jhalmen/openloop-hrdwr/looper.kicad_pcb

## KiCad design looper.kicad_pcb (2020-03-23)

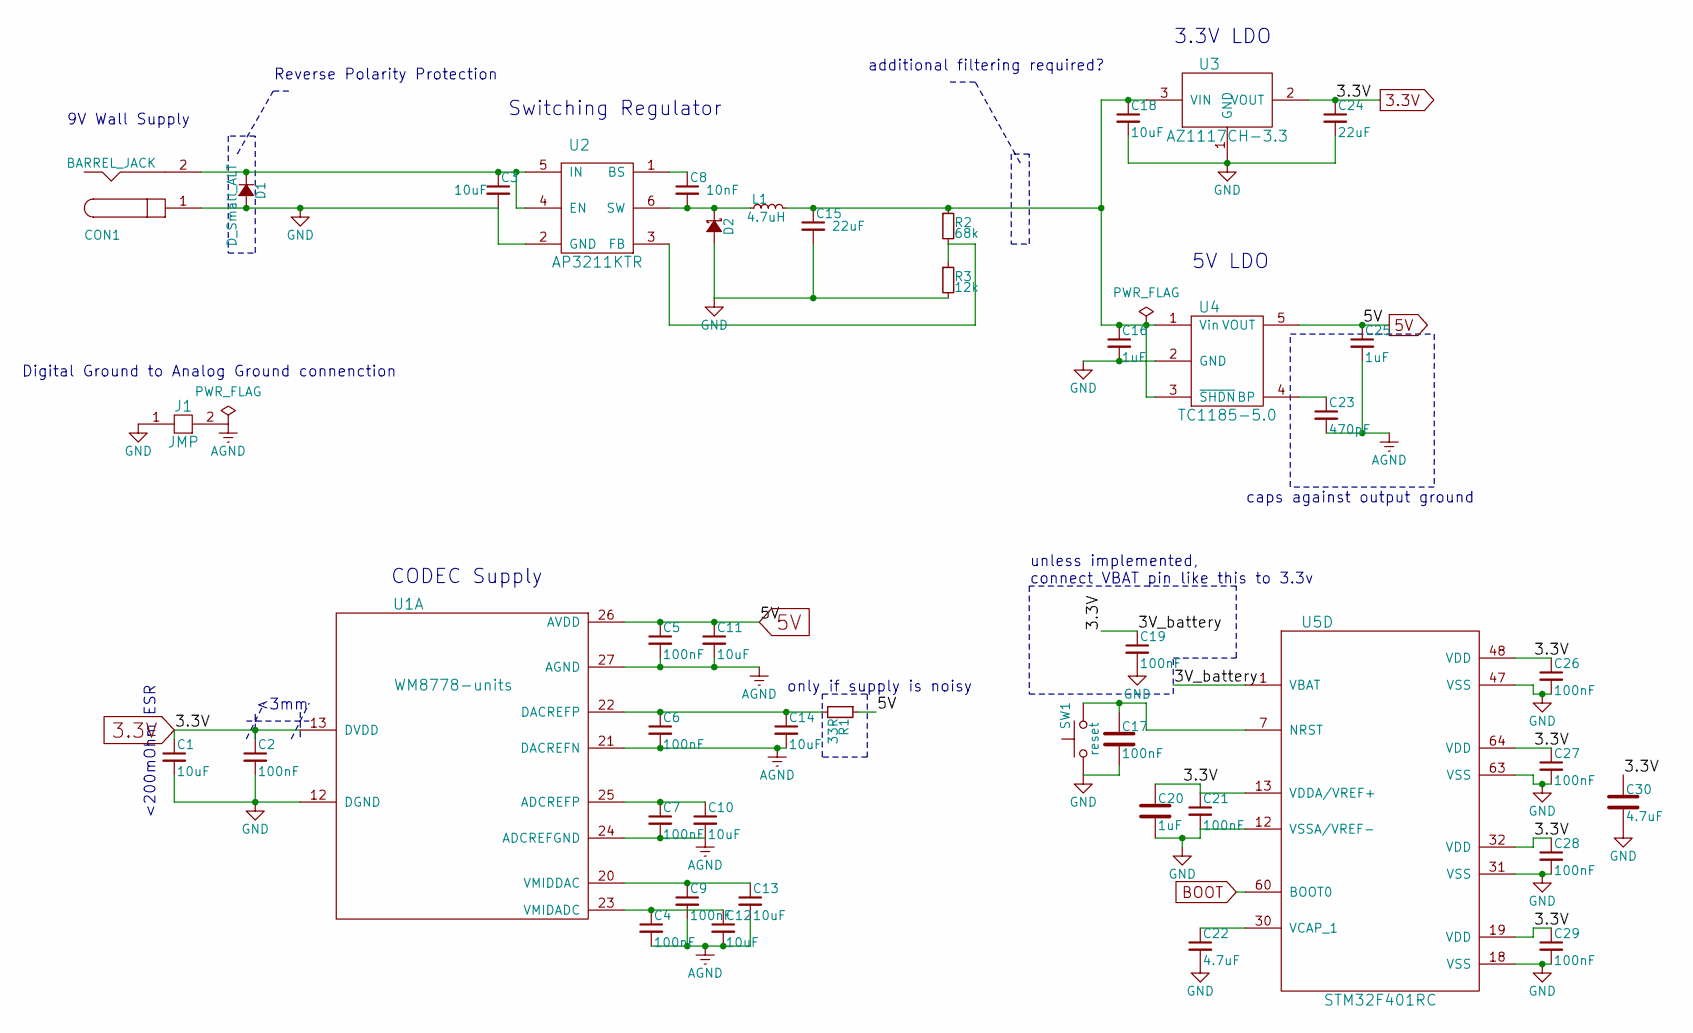
[picture p1: schematic power.sch, OpenLoop]

Parts:
C1, C3, C10, C11, C12, C13, C14, C18: 10uF; C_0805_HandSoldering
C2, C4, C5, C6, C7, C9, C17, C19, C21, C26, C27, C28, C29: 100nF; C_0805_HandSoldering
C8: 10nF; C_0805_HandSoldering
C15, C24: 22uF; C_0805_HandSoldering
C16, C20, C25: 1uF; C_0805_HandSoldering
C22, C30: 4.7uF; C_0805_HandSoldering
C23: 470pF; C_0805_HandSoldering
CON1: BARREL_JACK; PJ-037A
D1: D_Small_ALT; D_DO-35_SOD27_P7.62mm_Horizontal
D2: D_Schottky_Small_ALT; D_DO-35_SOD27_P7.62mm_Horizontal
J1: JMP; netconnector
L1: 4.7uH; Resistor_SMDuniversal_0805to1206_HandSoldering
R1: 33R; R_Axial_DIN0207_L6.3mm_D2.5mm_P7.62mm_Horizontal
R2: 68k; R_Axial_DIN0207_L6.3mm_D2.5mm_P7.62mm_Horizontal
R3: 12k; R_Axial_DIN0207_L6.3mm_D2.5mm_P7.62mm_Horizontal
SW1: reset; SW_PUSH_6mm
U1: WM8778-units; SSOP-28_5.3x10.2mm_Pitch0.65mm_HandSolder
U2: AP3211KTR; SOT-23-6_Handsoldering
U3: AZ1117CH-3.3; SOT-223-3Lead_TabPin2_HandSoldering
U4: TC1185-5.0; SOT-23-5_HandSoldering
U5: STM32F401RC; LQFP-64_10x10mm_Pitch0.5mm_HandSolder

Connections:
3.3V: C1.1, C2.1, C19.1, C20.1, C21.1, C24.1, C26.1, C27.1, C28.1, C29.1, C30.1, U1.13 (DVDD), U3.2 (VOUT), U5.1 (VBAT), U5.13 (VDDA/VREF+), U5.19 (VDD), U5.32 (VDD), U5.48 (VDD), U5.64 (VDD); also elsewhere on the board
5V: C5.1, C11.1, C25.1, R1.1, U1.26 (AVDD), U4.5 (VOUT); also elsewhere on the board
BOOT: U5.60 (BOOT0); also elsewhere on the board
GND: C1.2, C2.2, C3.2, C15.2, C16.2, C17.2, C18.2, C19.2, C20.2, C21.2, C22.2, C24.2, C26.2, C27.2, C28.2, C29.2, C30.2, CON1.1, D1.2 (A), D2.2 (A), J1.1, R3.2, SW1.1, U1.12 (DGND), U2.2 (GND), U3.1 (GND), U4.2 (GND), U5.12 (VSSA/VREF-), U5.18 (VSS), U5.31 (VSS), U5.47 (VSS), U5.63 (VSS); also elsewhere on the board
unnamed: C3.1, CON1.2, D1.1 (K), U2.4 (EN), U2.5 (IN)
unnamed: C8.1, U2.1 (BS)
unnamed: C8.2, D2.1 (K), L1.1, U2.6 (SW)
unnamed: C7.1, C10.1, U1.25 (ADCREFP)
unnamed: C4.1, C12.1, U1.23 (VMIDADC)
unnamed: C9.1, C13.1, U1.20 (VMIDDAC)
unnamed: C6.1, C14.1, R1.2, U1.22 (DACREFP)
unnamed: C15.1, C16.1, C18.1, L1.2, R2.1, U3.3 (VIN), U4.1 (Vin), U4.3 (~SHDN)
unnamed: C17.1, SW1.2, U5.7 (NRST)
unnamed: C22.1, U5.30 (VCAP_1)
unnamed: C23.1, U4.4 (BP)
unnamed: R2.2, R3.1, U2.3 (FB)

Notes on the sheet:
Digital Ground to Analog Ground connenction
9V Wall Supply
Reverse Polarity Protection
additional filtering required?
<3mm
<200mOhm ESR
only if supply is noisy
CODEC Supply
Switching Regulator
3.3V LDO
5V LDO
caps against output ground
unless implemented, connect VBAT pin like this to 3.3v

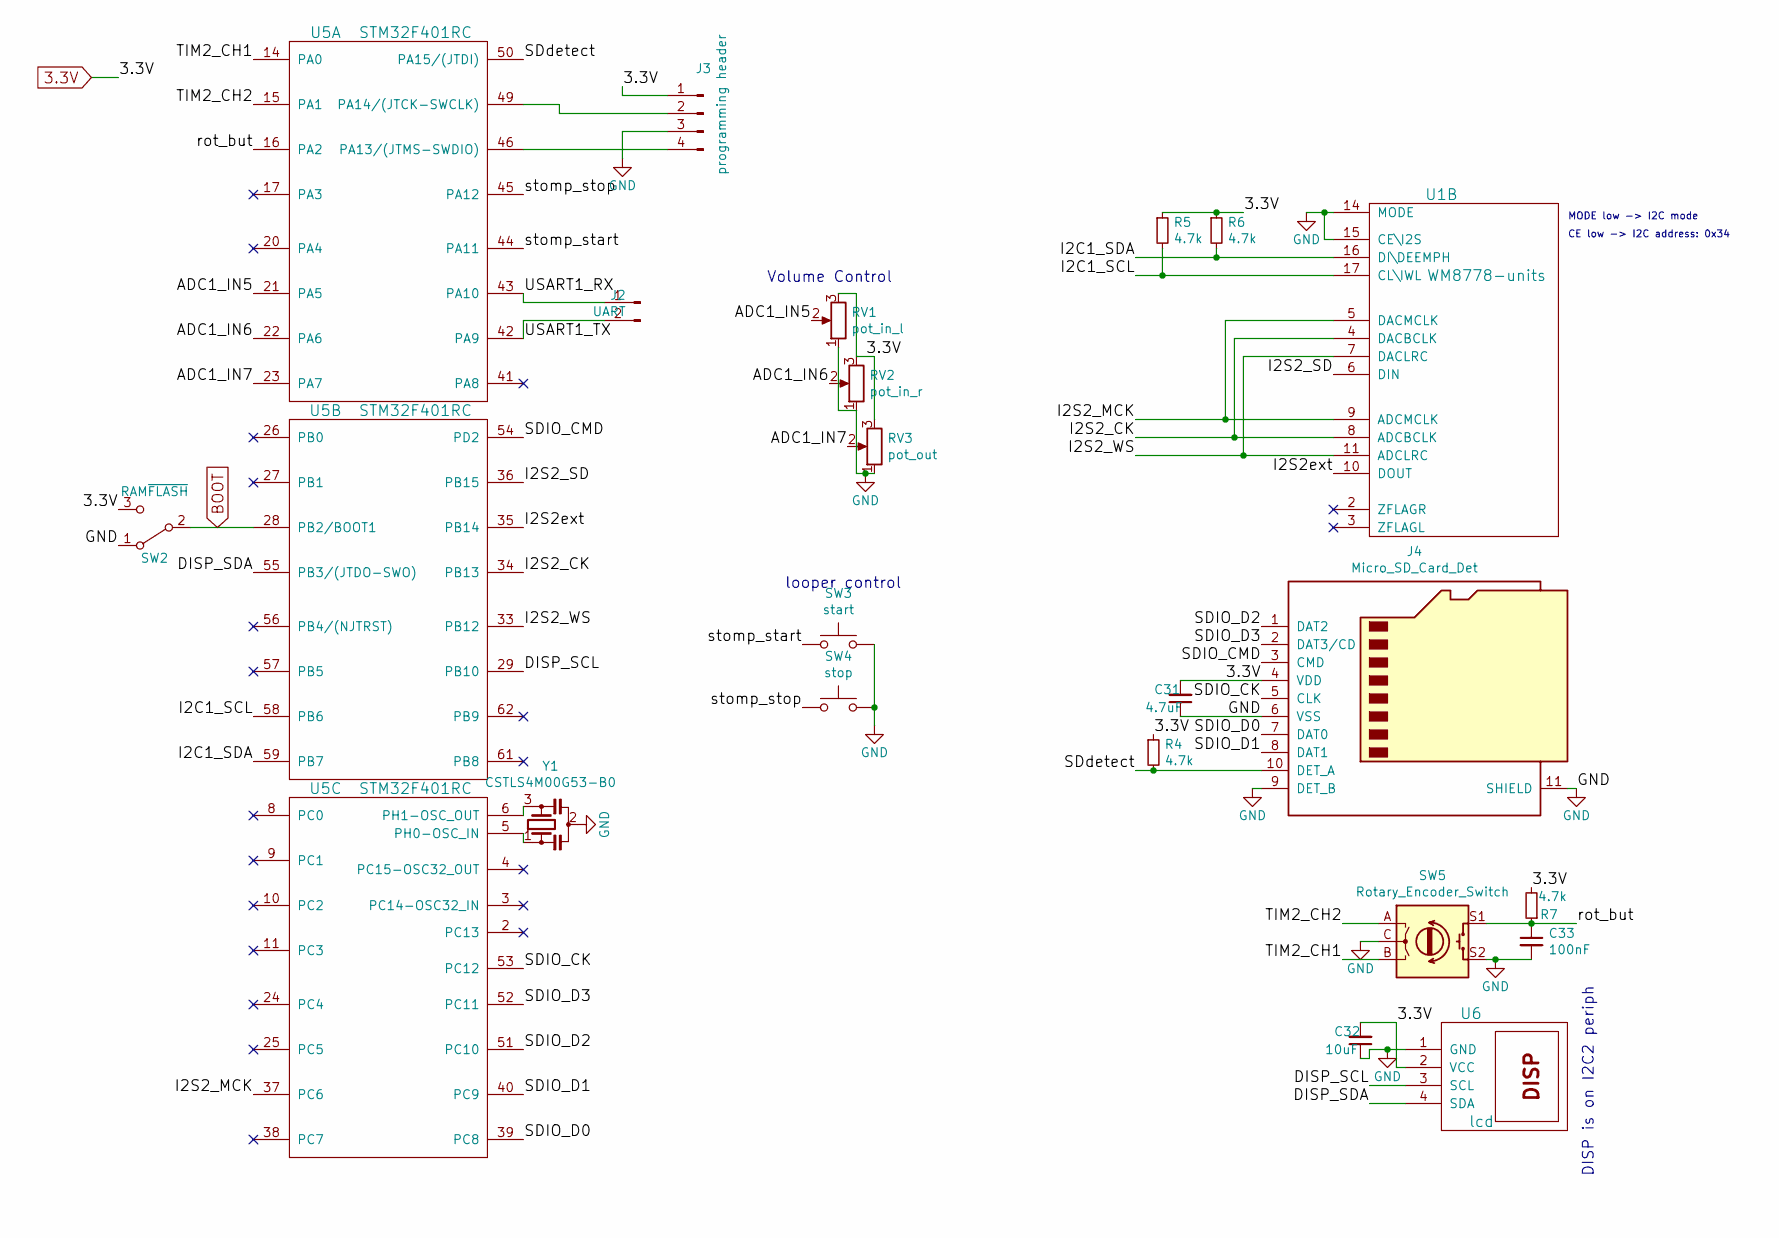
[picture p2: schematic controller.sch, OpenLoop]

Parts:
C31: 4.7uF; C_0805_HandSoldering
C32: 10uF; C_0805_HandSoldering
C33: 100nF; C_0805_HandSoldering
J2: UART; Pin_Header_Straight_1x02_Pitch2.54mm
J3: programming header; Pin_Header_Straight_1x04_Pitch2.54mm
J4: Micro_SD_Card_Det; SD-503182_Molex_micro_SD_HandSolder
R4, R5, R6, R7: 4.7k; R_Axial_DIN0207_L6.3mm_D2.5mm_P7.62mm_Horizontal
RV1: pot_in_l; Potentiometer_WirePads_Small
RV2: pot_in_r; Potentiometer_WirePads_Small
RV3: pot_out; Potentiometer_WirePads_Small
SW2: RAM~FLASH; SW_Micro_SPST
SW3: start; SW_PUSH_6mm
SW4: stop; SW_PUSH_6mm
SW5: Rotary_Encoder_Switch; EN11-HSM
U1: WM8778-units; SSOP-28_5.3x10.2mm_Pitch0.65mm_HandSolder
U5: STM32F401RC; LQFP-64_10x10mm_Pitch0.5mm_HandSolder
U6: lcd; Socket_Strip_Straight_1x04_Pitch2.54mm
Y1: CSTLS4M00G53-B0; Resonator_muRata_CSTLSxxxG-3pin_w8.0mm_h3.0mm

Connections:
3.3V: C31.2, C32.2, J3.1, J4.4 (VDD), R4.1, R5.1, R6.1, R7.2, RV1.3, RV2.3, RV3.3, SW2.3 (C), U6.2 (VCC); also elsewhere on the board
/controller/ADC1_IN5: RV1.2, U5.21 (PA5)
/controller/ADC1_IN6: RV2.2, U5.22 (PA6)
/controller/ADC1_IN7: RV3.2, U5.23 (PA7)
/controller/DISP_SCL: U5.29 (PB10), U6.3 (SCL)
/controller/DISP_SDA: U5.55 (PB3/(JTDO-SWO)), U6.4 (SDA)
/controller/I2C1_SCL: R5.2, U1.17 (CL\IWL), U5.58 (PB6)
/controller/I2C1_SDA: R6.2, U1.16 (DI\DEEMPH), U5.59 (PB7)
/controller/I2S2_CK: U1.4 (DACBCLK), U1.8 (ADCBCLK), U5.34 (PB13)
/controller/I2S2_MCK: U1.5 (DACMCLK), U1.9 (ADCMCLK), U5.37 (PC6)
/controller/I2S2_SD: U1.6 (DIN), U5.36 (PB15)
/controller/I2S2_WS: U1.7 (DACLRC), U1.11 (ADCLRC), U5.33 (PB12)
/controller/I2S2ext: U1.10 (DOUT), U5.35 (PB14)
/controller/SDIO_CK: J4.5 (CLK), U5.53 (PC12)
/controller/SDIO_CMD: J4.3 (CMD), U5.54 (PD2)
/controller/SDIO_D0: J4.7 (DAT0), U5.39 (PC8)
/controller/SDIO_D1: J4.8 (DAT1), U5.40 (PC9)
/controller/SDIO_D2: J4.1 (DAT2), U5.51 (PC10)
/controller/SDIO_D3: J4.2 (DAT3/CD), U5.52 (PC11)
/controller/SDdetect: J4.10 (DET_A), R4.2, U5.50 (PA15/(JTDI))
/controller/TIM2_CH1: SW5.B, U5.14 (PA0)
/controller/TIM2_CH2: SW5.A, U5.15 (PA1)
/controller/USART1_RX: J2.1, U5.43 (PA10)
/controller/USART1_TX: J2.2, U5.42 (PA9)
/controller/rot_but: C33.1, R7.1, SW5.S1, U5.16 (PA2)
/controller/stomp_start: SW3.1, U5.44 (PA11)
/controller/stomp_stop: SW4.1, U5.45 (PA12)
BOOT: SW2.2 (B), U5.28 (PB2/BOOT1); also elsewhere on the board
GND: C31.1, C32.1, C33.2, J3.3, J4.6 (VSS), J4.9 (DET_B), J4.11 (SHIELD), RV1.1, RV2.1, RV3.1, SW2.1 (A), SW3.2, SW4.2, SW5.C, SW5.S2, U1.14 (MODE), U1.15 (CE\I2S), U6.1 (GND), Y1.2; also elsewhere on the board
unnamed: J3.2, U5.49 (PA14/(JTCK-SWCLK))
unnamed: J3.4, U5.46 (PA13/(JTMS-SWDIO))
unnamed: U5.5 (PH0-OSC_IN), Y1.1
unnamed: U5.6 (PH1-OSC_OUT), Y1.3

Notes on the sheet:
MODE low -> I2C mode
CE low -> I2C address: 0x34
DISP is on I2C2 periph
Volume Control
looper control

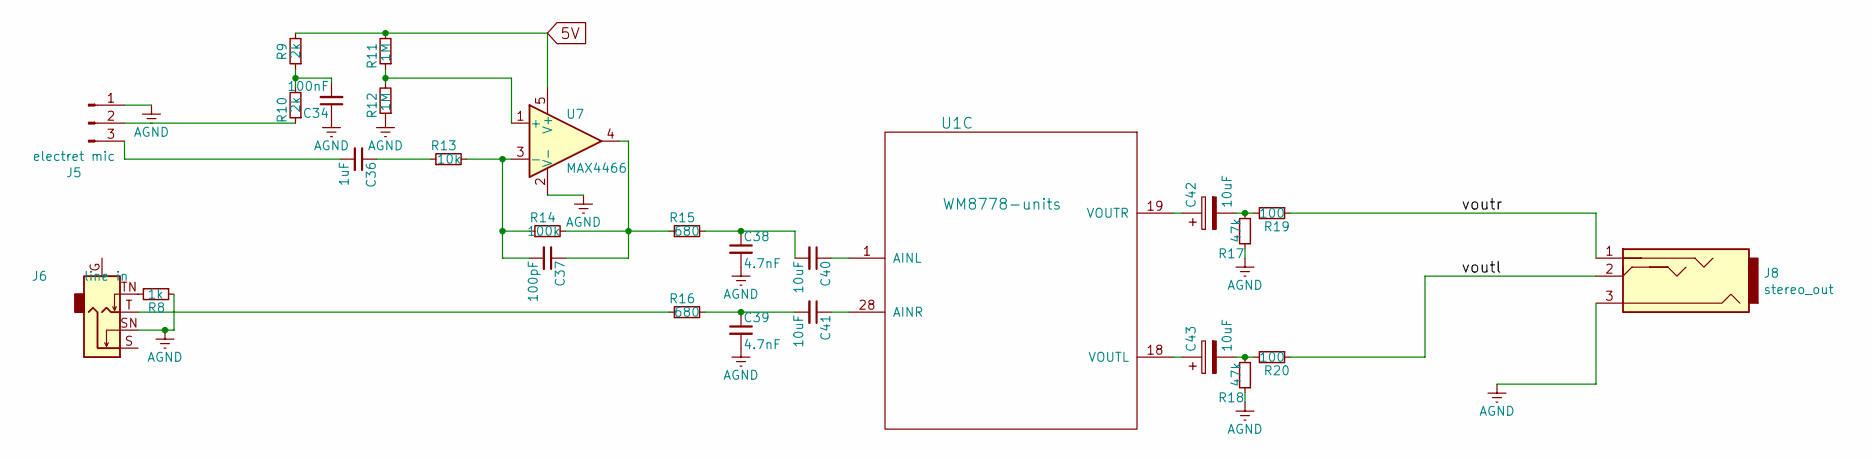
[picture p3: schematic codec.sch, OpenLoop]

Parts:
C34: 100nF; C_0805_HandSoldering
C36: 1uF; C_0805_HandSoldering
C37: 100pF; C_0805_HandSoldering
C38, C39: 4.7nF; C_0805_HandSoldering
C40, C41: 10uF; C_0805_HandSoldering
C42, C43: 10uF; CP_Radial_D5.0mm_P2.00mm
J5: electret mic; Socket_Strip_Straight_1x02_Pitch2.54mm
J6: line in; Socket_Strip_Straight_1x03_Pitch2.54mm
J8: stereo_out; Socket_Strip_Straight_1x03_Pitch2.54mm
R8: 1k; R_Axial_DIN0207_L6.3mm_D2.5mm_P7.62mm_Horizontal
R9, R10: 2k; R_Axial_DIN0207_L6.3mm_D2.5mm_P7.62mm_Horizontal
R11, R12: 1M; R_Axial_DIN0207_L6.3mm_D2.5mm_P7.62mm_Horizontal
R13: 10k; R_Axial_DIN0207_L6.3mm_D2.5mm_P7.62mm_Horizontal
R14: 100k; R_Axial_DIN0207_L6.3mm_D2.5mm_P7.62mm_Horizontal
R15, R16: 680; R_Axial_DIN0207_L6.3mm_D2.5mm_P7.62mm_Horizontal
R17, R18: 47k; R_Axial_DIN0207_L6.3mm_D2.5mm_P7.62mm_Horizontal
R19, R20: 100; R_Axial_DIN0207_L6.3mm_D2.5mm_P7.62mm_Horizontal
U1: WM8778-units; SSOP-28_5.3x10.2mm_Pitch0.65mm_HandSolder
U7: MAX4466; SOT-353_SC-70-5_Handsoldering

Connections:
5V: R9.2, R11.2, U7.5 (V+); also elsewhere on the board
/Codec/voutl: J8.2, R20.1; also elsewhere on the board
/Codec/voutr: J8.1, R19.1; also elsewhere on the board
unnamed: C34.2, R9.1, R10.2
unnamed 44: R11.1, R12.2, U7.1 (+); also elsewhere on the board
unnamed 45: J5.2, R10.1; also elsewhere on the board
unnamed: C36.1, R13.1
unnamed 47: C37.1, R14.2, R15.1, U7.4; also elsewhere on the board
unnamed: C37.2, R13.2, R14.1, U7.3 (-)
unnamed: C38.1, C40.2, R15.2
unnamed: C39.1, C41.2, R16.2
unnamed: C40.1, U1.1 (AINL)
unnamed: C41.1, U1.28 (AINR)
unnamed: C42.1, U1.19 (VOUTR)
unnamed: C42.2, R17.2, R19.2
unnamed: C43.1, U1.18 (VOUTL)
unnamed: C43.2, R18.2, R20.2
unnamed: J6.T, R16.1
unnamed: J6.TN, R8.2

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
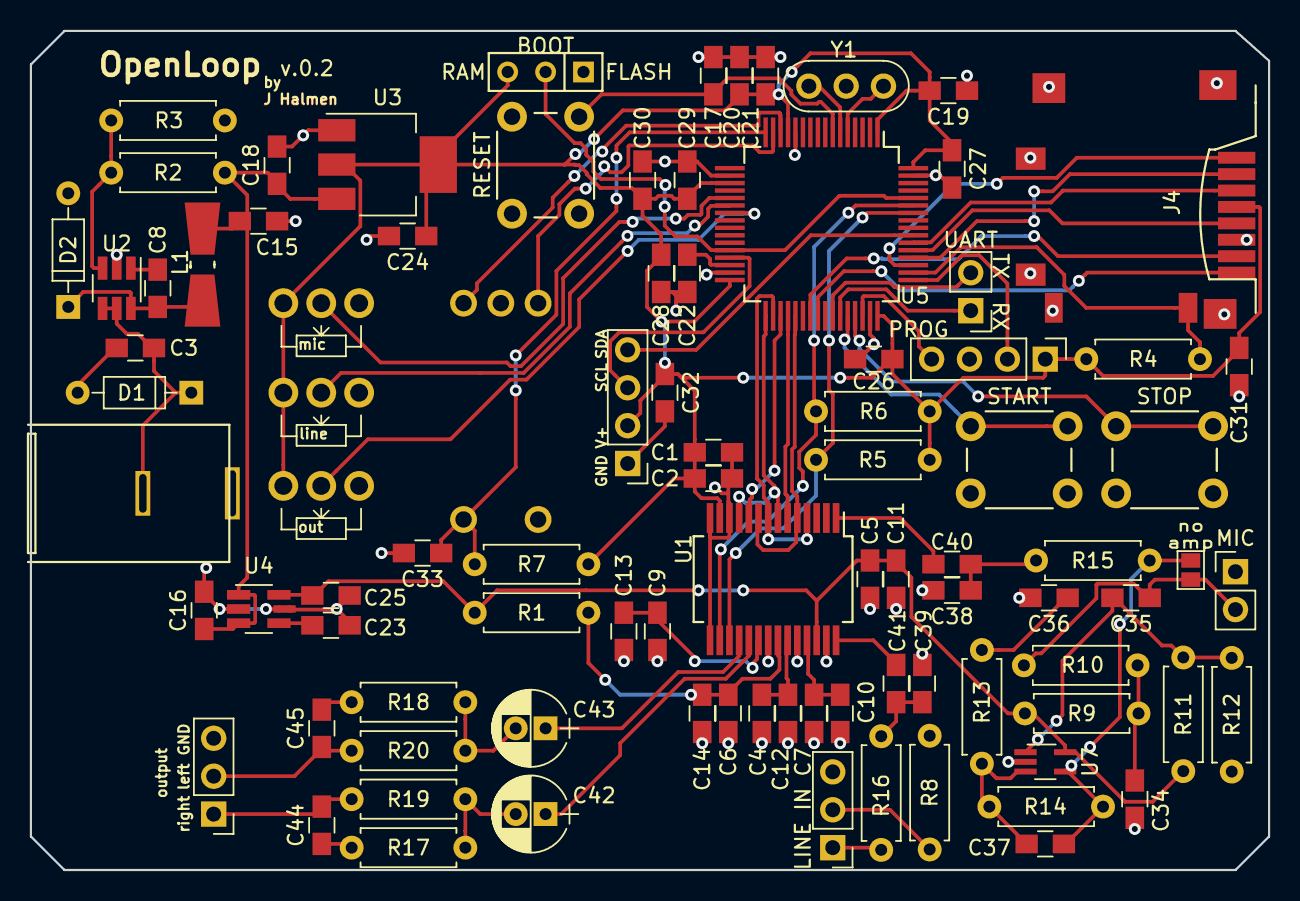
[picture p4: board looper.kicad_pcb from above]

Board: 2 copper layers, 83.0 x 56.2 mm, 93 parts (0 on the bottom side), 65 nets.

Other parts of the board:
C35: 10nF C0G/NP0; C_0805_HandSoldering
C44, C45: 4.7nF C0G/NP0; C_0805_HandSoldering
J7: line/~mic; GS2

Their connections:
/Codec/voutl: C45.1; also elsewhere on the board
/Codec/voutr: C44.1; also elsewhere on the board
unnamed 44: C35.1; also elsewhere on the board
unnamed 45: C35.2, J7.2; also elsewhere on the board
unnamed 47: J7.1; also elsewhere on the board
