jhalmen/openloop-hrdwr/(commit log)

2017-05-02 ksch: add buck converter to lib
    add datasheet links for both codec and buck
2017-05-02 ksch: begin drawing schematics
    [codec.sch, looper.sch, power.sch]
2017-05-02 ksch: use schottky diode for switching regulator
    [power.sch]
2017-05-02 ksch: fix error in codec supply
    [power.sch]
2017-05-02 ksch: add stm32f401rc to lib
2017-05-02 ksch: add uC power and programming pins
    [controller.sch, looper.sch, power.sch]
2017-05-02 ksch: add I2S interface connections
    [controller.sch]
2017-06-07 ksch: use i2s2 and i2s3 for codec
    [controller.sch]
2017-06-07 ksch: change to use i2s2 bidirectional, free i2s3
    [controller.sch]
2017-06-07 ksch: add boot0 pin to switch
    [power.sch]
2017-06-07 ksch: add filter to both analog out channels
    [codec.sch]
2017-06-07 ksch: add codec control interface as i2c1
    [controller.sch]
2017-06-07 ksch: use own page layout
    [codec.sch, looper.sch, power.sch]
2017-09-24 kpcb: start adding footprints
    SSOP28 -- codec
    LQFP64 -- uC
    SD_molex -- uSDcard
2017-09-25 kpcb: add more footprints
2017-09-27 ksch: add stuff that isn't on soldered prototype yet
    this hopefully completes the rev. A schematics
    [codec.sch, controller.sch, looper.sch, power.sch]
2017-09-27 ksch: reannotate schematics to have a single style of part-naming
    [codec.sch, controller.sch, power.sch]
2017-09-29 ksch: change power connector to DC5525
    [power.sch]
2017-09-29 ksch: fix footprintproblem, change some labels
    [codec.sch, controller.sch, looper.sch]
2017-09-29 ksch: change I2S2ext from PC2 to PB14 to make routing easier
    [controller.sch]
2017-09-29 ksch: switch encoder connections to make routing easier
    [controller.sch]
2017-10-01 ksch: move SDdetect pin to PA15 to make routing easier
    [controller.sch]
2017-10-01 ksch: move stomp buttons to make routing easier
    [controller.sch]
2017-10-01 ksch: rotate resistor to make routing easier
    [controller.sch]
2017-10-02 kpcb: fix netconnector footprint
2017-10-02 kpcb: add first pcb design
2017-10-02 k: fix pcb
    power connector trouble
    wrong footprint for caps
    [codec.sch, looper.kicad_pcb, power.sch]
2017-10-09 ksch: change component values to include the unit except for resistors add more info to some devices
    [codec.sch, controller.sch, looper.kicad_pcb, looper.sch, power.sch]
2018-09-06 fix mirrored sdcard footprints
2018-09-06 pcb: use fixed sd footprints, reroute
    [looper.kicad_pcb]
2018-09-08 migrate to kicad v5
    [codec.sch, controller.sch, looper.kicad_pcb, looper.sch, power.sch]
2019-02-02 ready for print
    [codec.sch, controller.sch, looper.sch, power.sch]
2019-02-02 update codec schematic: mic power
    [codec.sch]
2020-03-23 add gitignore, schematic lib cache
    [codec.sch, controller.sch, looper.kicad_pcb, looper.sch, power.sch]
